sebaxe07/Tino-Robot/Tino-raspberrypi/README.md

# Tino-raspberrypi
si lavora qui in developmentsss
ready for new life
