sebaxe07/Tino-Robot/Thesis TinoV2/Chapters/implementation.tex

This chapter details the comprehensive implementation of the Tino V2 robot system, covering the complete redesign and upgrade of the platform. The implementation encompasses the transition from legacy Raspberry Pi-based architecture to a modern ROS2-based system running on NVIDIA Orin Nano, the integration of advanced sensing capabilities including SLAM and human detection, hardware redesign for improved reliability and performance, and the development of VR integration capabilities. Each section provides detailed technical implementation details, design decisions, and validation results that demonstrate the enhanced capabilities of the Tino V2 platform.
