sebaxe07/Tino-Robot/Thesis TinoV2/Images/bridgepos.png

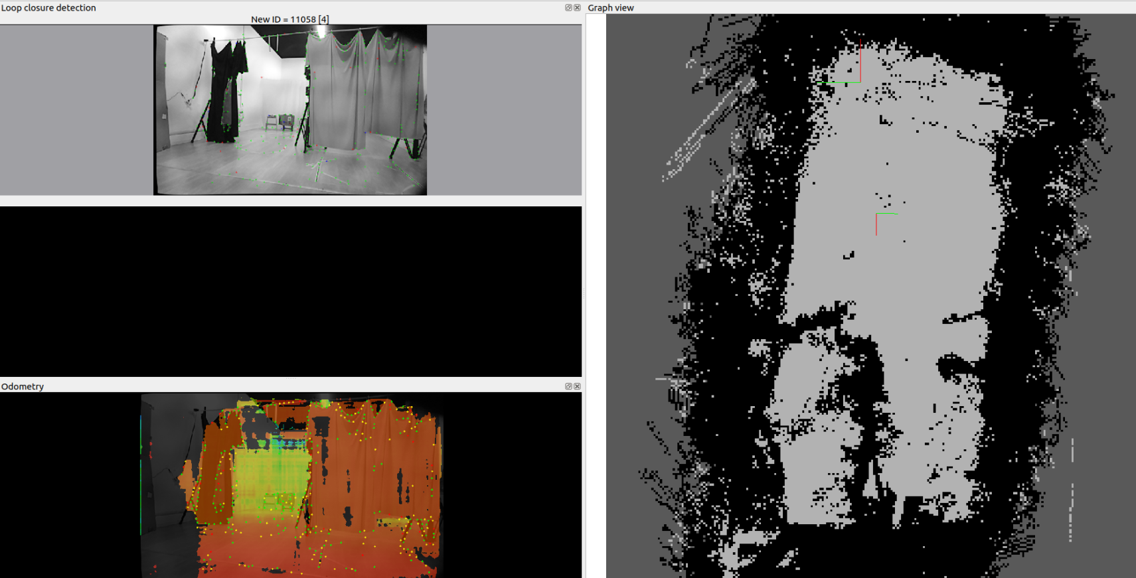
Thesis TinoV2/Images/bridgepos.png
