sebaxe07/Tino-Robot/Thesis TinoV2/Images/buttonpos.png

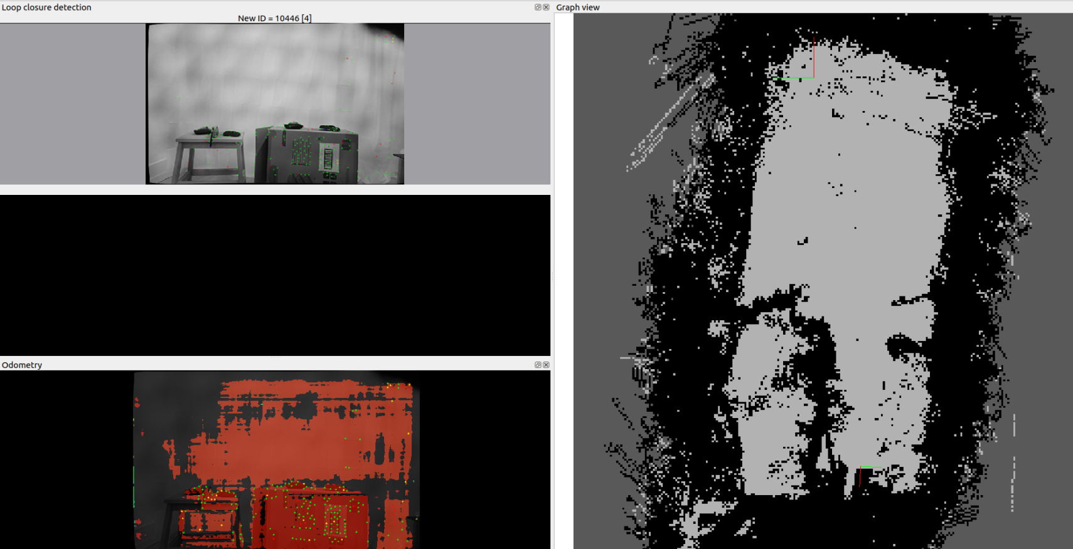
Thesis TinoV2/Images/buttonpos.png
