sebaxe07/Tino-Robot/Thesis TinoV2/Images/CameraCasingMesh (3).jpg

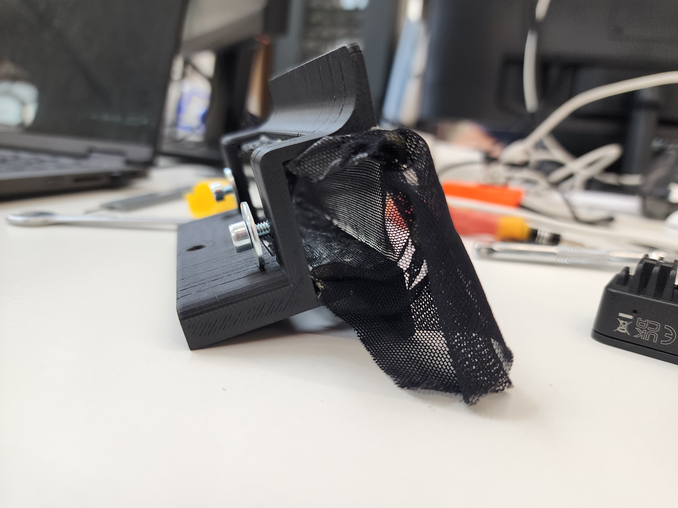
Thesis TinoV2/Images/CameraCasingMesh (3).jpg
