sebaxe07/Tino-Robot/Thesis TinoV2/Images/cleanRTABMap.png

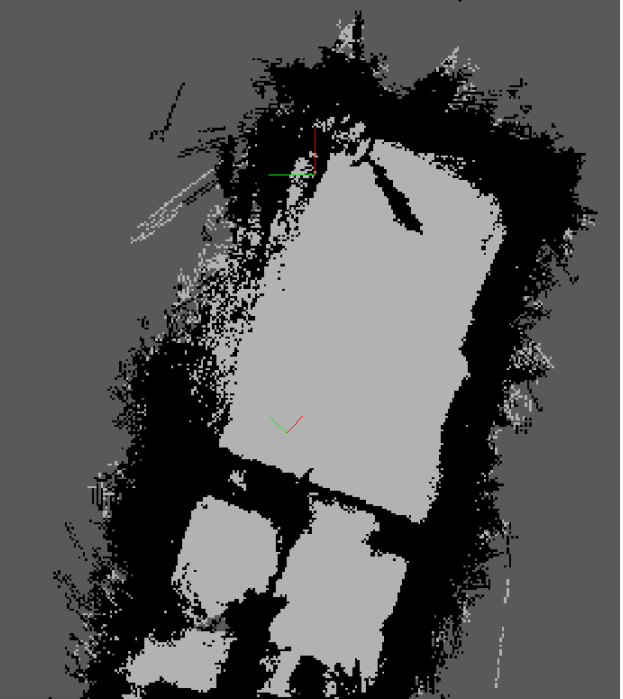
Thesis TinoV2/Images/cleanRTABMap.png
