sebaxe07/Tino-Robot/Thesis TinoV2/Images/InternalWithSpeakers.jpg

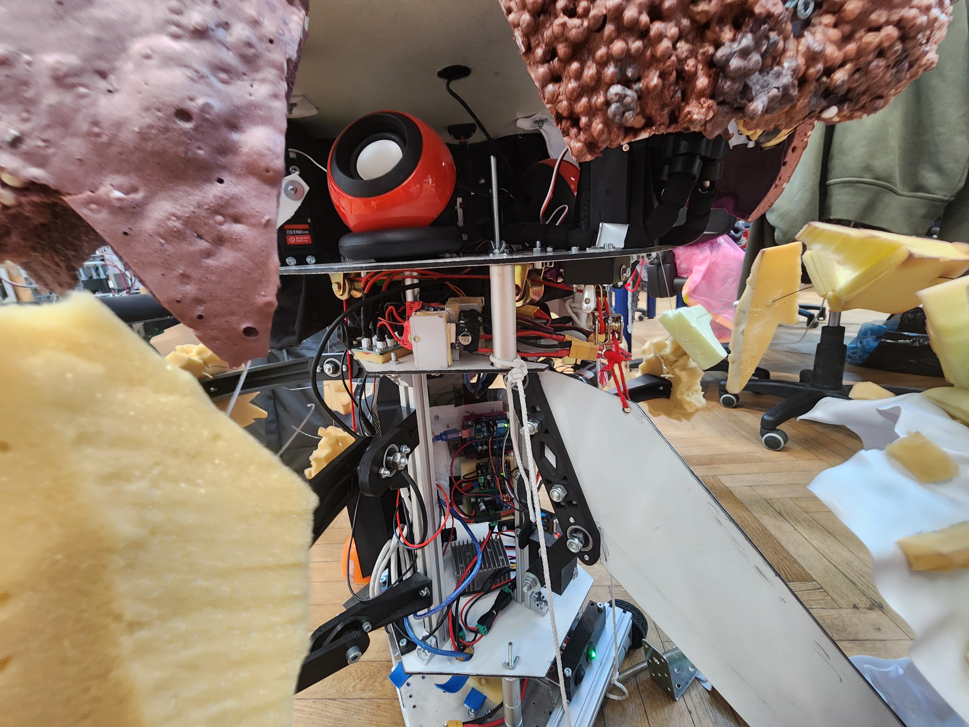
Thesis TinoV2/Images/InternalWithSpeakers.jpg
