sebaxe07/Tino-Robot/Thesis TinoV2/Images/NewBaseDifferentialDrive (4).jpg

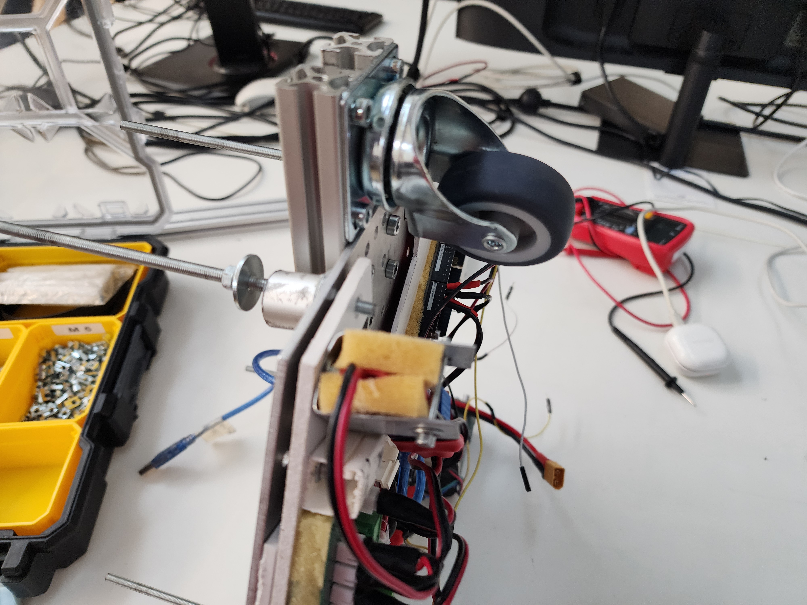
Thesis TinoV2/Images/NewBaseDifferentialDrive (4).jpg
