sebaxe07/Tino-Robot/Thesis TinoV2/Images/NewHeadDoubleJoint (3).jpg

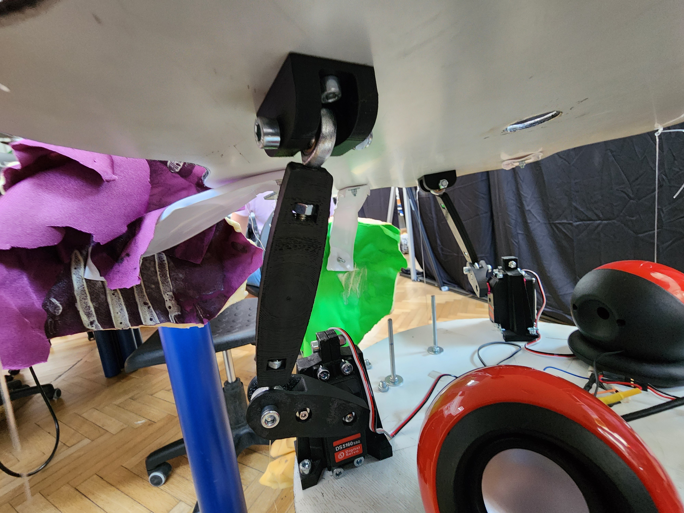
Thesis TinoV2/Images/NewHeadDoubleJoint (3).jpg
