sebaxe07/Tino-Robot/Thesis TinoV2/Images/NewHeadDoubleJoint.jpg

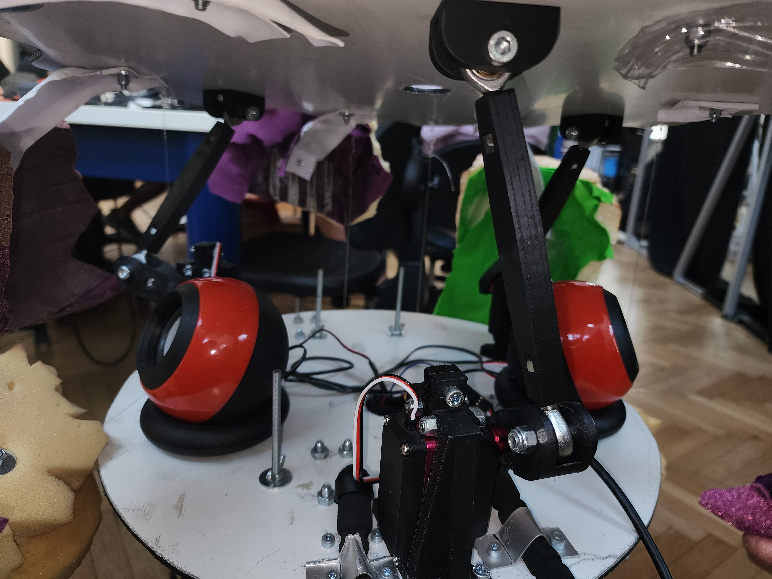
Thesis TinoV2/Images/NewHeadDoubleJoint.jpg
