sebaxe07/Tino-Robot/Thesis TinoV2/Images/OriginalTriskarBase.jpg

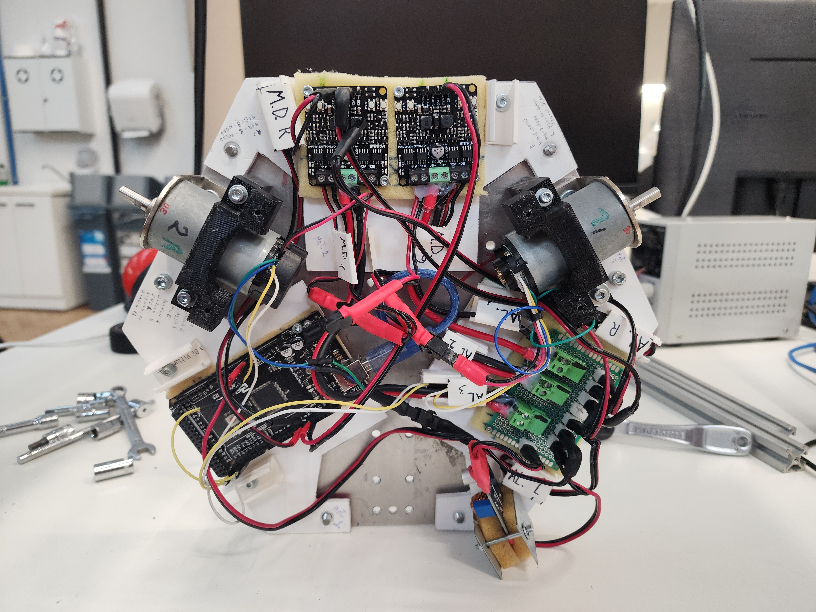
Thesis TinoV2/Images/OriginalTriskarBase.jpg
