sebaxe07/Tino-Robot/Thesis TinoV2/Images/platformpos.png

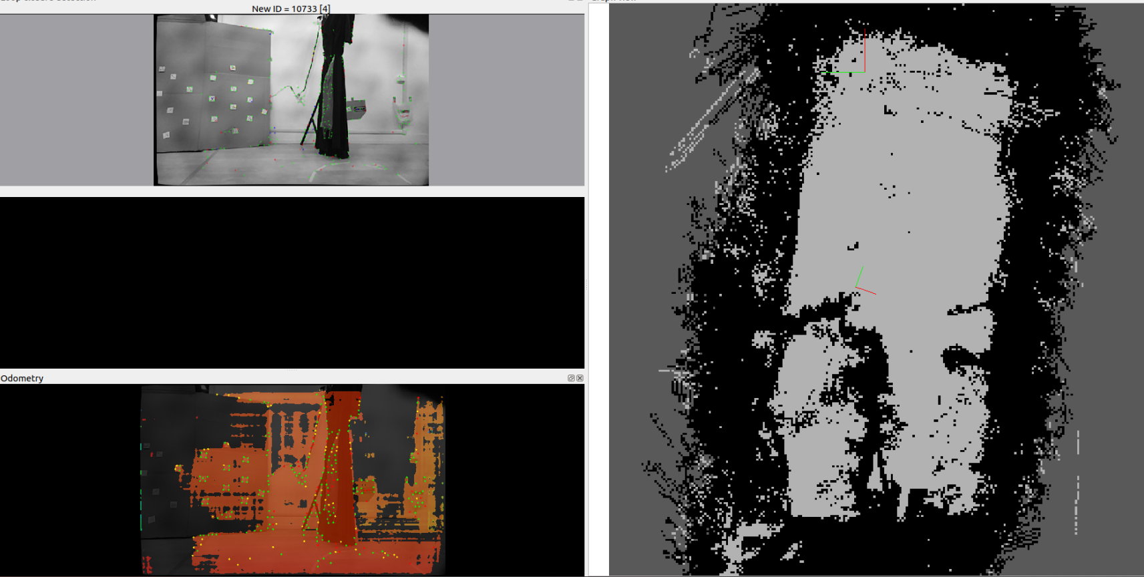
Thesis TinoV2/Images/platformpos.png
