sebaxe07/Tino-Robot/Thesis TinoV2/Images/TinoBumper (3).jpg

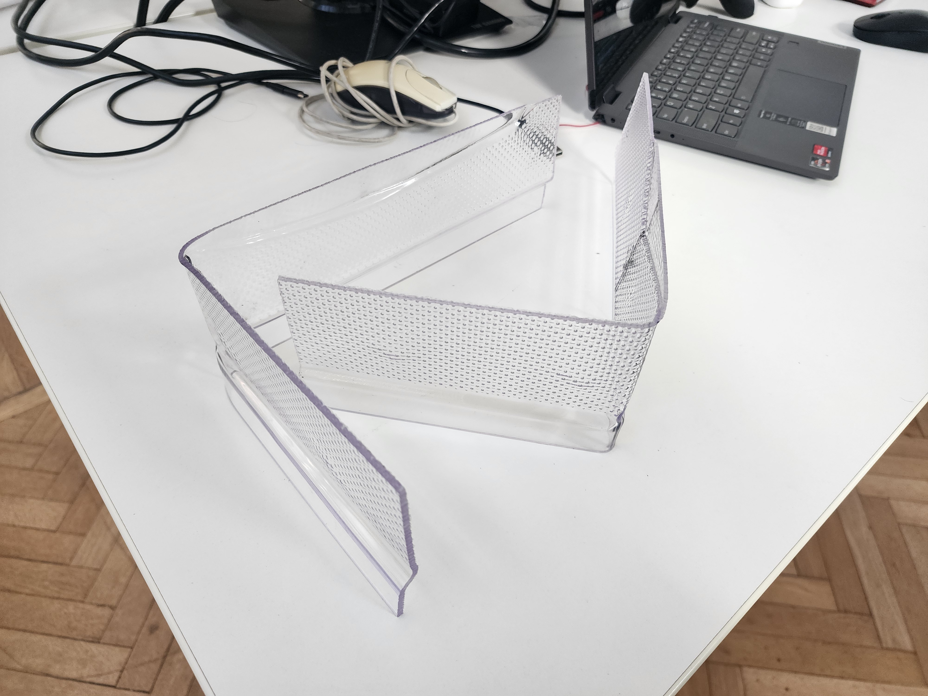
Thesis TinoV2/Images/TinoBumper (3).jpg
