sebaxe07/Tino-Robot/The Revenge of the Mazes(1-10).csv

ID | Start time | Completion time | Email | Name | Last modified time | Write the ID provided by Alessandro and Sebastian after the experiment | What is your gender? | How old are you? | What is your country of origin? | If you took part in both the experiences, which one did you do first? | Did you take part in the VR Experience? | What are three key words to describe your feelings during the experience? | I am familiar with VR | I felt uncomfortable using the VR headset today | I was able to navigate the environment | I felt like I was trapped | I felt I was able to go wherever I wanted | it was easy to move around | I felt like the obstacles were dangerous | the environment was interesting/stimulating | the environment was annoying | I felt immersed in the environment | I enjoyed the environment | it was easy/intuitive to understand how the game worked | it was easy/intuitive to understand how to interact with the objects | playing the game was frustrating | I felt as if the virtual body was my body | I felt as if the virtual body was an extension of my body | I felt like I could control the virtual body as if it was my own body | the movements of the virtual body were caused by my movements | I felt as if the movements of the virtual body were influencing my own movements | I felt out of my body | at some point I felt as if my real body was starting to take on the posture or shape of the virtual body | It was intuitive to move the virtual body | I enjoyed the movements of the virtual body | I enjoyed the appearance of the virtual body | I saw another being in the environment | I felt a connection with the other being | I was able to understand the other being | I wanted to communicate with the other being | I felt I was able to communicate with the other being | Have you seen this room? | What did you do there? | Did you interact with this platform? | If yes, what made you do it? | Did you find this room? | What did you do there?2 | Did you finish the game in this room? | Did you feel your emotions change during the experience? | How did your emotions change during the experience? | How much did you enjoy the VR experience? | What did you like the most about the experience? | What did you like the least about the experience? | Any final comments, suggestions, or rants? | Did you take part in the Robot experience? | I have seen/interacted with a robot before | I liked the robot appearance | Have you interacted with the Robot during the experience? | How much did the robot's appearance impact how you interacted with it?
3 | 7/21/25 6:56:20 | 7/21/25 7:12:52 | anonymous |  |  | 1 | Man | 24 | Italy | The Robot Experience | Yes | Amazed Stuck Frustrated | Strongly Agree | Strongly Disagree | More Disagree Than Agree | Strongly Agree | Disagree | Strongly Disagree | Strongly Agree | Agree | Disagree | Strongly Agree | Strongly Agree | Agree | More Disagree Than Agree | Disagree | More Disagree Than Agree | More Disagree Than Agree | More Disagree Than Agree | More Agree Than Disagree | More Agree Than Disagree | Agree | More Agree Than Disagree | Strongly Disagree | Disagree | Agree | Yes | More Agree Than Disagree | Disagree | Disagree | Strongly Disagree | Yes | Provato a schiacciare le piattaforme | Yes | Passarci sopra | Yes | Provato a entrarci | Yes | Yes | Prima ero divertito poi mi sono sentito frustrato perché Tino era davvero molto lento | 4 | The scene was very suggestive | Il movimento lento di Tino | Tino dovrebbe avere un buff sulla reattività ai miei controlli | Yes | Strongly Agree | Strongly Agree | Yes | 1
4 | 7/21/25 10:59:43 | 7/21/25 11:07:19 | anonymous |  |  | 3 | Man | 22 | Italy | I only took part in one experience | Yes | Puzzled, Amused, Frustrated | More Disagree Than Agree | Strongly Disagree | Agree | Agree | More Disagree Than Agree | More Agree Than Disagree | Disagree | Agree | Disagree | Strongly Agree | Agree | More Agree Than Disagree | Agree | Strongly Agree | More Disagree Than Agree | Agree | More Agree Than Disagree | Strongly Agree | Strongly Agree | Disagree | Disagree | Agree | More Disagree Than Agree | More Agree Than Disagree | Yes | Disagree | Disagree | Agree | Disagree | No |  | Yes | The bright color | No |  | No | No |  | 3 | The environment | Getting stuck
5 | 7/21/25 10:59:55 | 7/21/25 11:15:35 | anonymous |  |  | 2 | Man | 22 | Colombia | The VR Experience | Yes | Frustratrd, interested, Curious | Strongly Disagree | Strongly Disagree | Strongly Agree | More Disagree Than Agree | More Disagree Than Agree | Strongly Agree | More Agree Than Disagree | Strongly Agree | Disagree | Agree | Agree | Agree | Strongly Agree | Strongly Agree | Disagree | Disagree | Disagree | More Disagree Than Agree | Disagree | Disagree | More Disagree Than Agree | Disagree | Disagree | Disagree | Yes | More Agree Than Disagree | More Agree Than Disagree | Disagree | More Disagree Than Agree | Yes | I went to step into the button | Yes | It was glowing | No |  | No | No |  | 3 | The scape room part | The movement of the VR body |  | Yes | Disagree | Agree | Yes | 5
6 | 7/21/25 11:32:39 | 7/21/25 11:42:57 | anonymous |  |  | 4 | Woman | 53 | Italy | I only took part in one experience | No |  |  |  |  |  |  |  |  |  |  |  |  |  |  |  |  |  |  |  |  |  |  |  |  |  |  |  |  |  |  |  |  |  |  |  |  |  |  |  |  |  |  |  | Yes | Strongly Disagree | More Agree Than Disagree | Yes | 6
7 | 7/21/25 12:09:28 | 7/21/25 12:34:03 | anonymous |  |  | 5 | Woman | 21 | Italy | The VR Experience | Yes | Confusione, frustrazione, simpatico | Agree | More Agree Than Disagree | More Agree Than Disagree | More Agree Than Disagree | Disagree | Disagree | Disagree | More Agree Than Disagree | More Disagree Than Agree | Agree | More Disagree Than Agree | More Agree Than Disagree | Strongly Agree | More Disagree Than Agree | Disagree | More Agree Than Disagree | Strongly Disagree | Agree | Strongly Agree | Disagree | Disagree | More Disagree Than Agree | Disagree | More Agree Than Disagree | Yes | Disagree | More Agree Than Disagree | Strongly Agree | More Agree Than Disagree | Yes | sono andata al cerchio blu in fondo | Yes | istinto | Yes | Su uno dei pulsanti | Yes | Yes | Stanchezza ma felicità di essere arrivata alla fine | 3 | Usare il Vr | Confusione |  | Yes | Strongly Agree | More Agree Than Disagree | Yes | 6
8 | 7/21/25 12:38:47 | 7/21/25 12:43:46 | anonymous |  |  | 7 | Man | 23 | Colombia | The VR Experience | Yes | Interesting, nauseous, lost | Agree | More Agree Than Disagree | Agree | More Disagree Than Agree | More Agree Than Disagree | More Agree Than Disagree | More Disagree Than Agree | Disagree | More Disagree Than Agree | Disagree | More Agree Than Disagree | Agree | Agree | More Agree Than Disagree | Disagree | More Disagree Than Agree | More Disagree Than Agree | More Agree Than Disagree | More Agree Than Disagree | More Disagree Than Agree | Agree | More Agree Than Disagree | More Disagree Than Agree | Disagree | Yes | Disagree | More Disagree Than Agree | Disagree | More Disagree Than Agree | Yes | Press the shiny button | Yes | Shiny | Yes | Point to a button | Yes | Yes | It was funny anyway | 3 | Using a vr | I was getting nauseous in the end |  | No
9 | 7/21/25 12:39:04 | 7/21/25 14:04:18 | anonymous |  |  | 6 | Man | 29 | Italy | The VR Experience | Yes | Immersive, confusing, interesting | Strongly Agree | Strongly Disagree | More Disagree Than Agree | Disagree | Disagree | More Disagree Than Agree | More Agree Than Disagree | More Disagree Than Agree | More Disagree Than Agree | More Agree Than Disagree | More Agree Than Disagree | More Agree Than Disagree | Agree | Agree | Disagree | More Agree Than Disagree | Strongly Disagree | More Agree Than Disagree | Agree | More Disagree Than Agree | Disagree | Disagree | More Disagree Than Agree | More Disagree Than Agree | Yes | More Disagree Than Agree | More Disagree Than Agree | More Agree Than Disagree | Disagree | Yes | I tried to move towards the blue circle opposite to me, because I thought it would activate some mechanism | Yes | I thought it would activate some kind of mechanism | Yes | I tried to move forward but I was stuck so I didn't finish the experiment | No | Yes | Much struggling | 3 | The fact that I was moving the robot using the VR and the bar | The movement, I didn't understand them | I understand that the objective of the experiment is to impersonificate the non-antropomorphic body, but I think some kind of disclaimer before starting could be nice | Yes | Agree | More Agree Than Disagree | Yes | 7
10 | 7/22/25 10:00:39 | 7/22/25 10:43:10 | anonymous |  |  | 9 | Man | 25 | Italy | The Robot Experience | Yes | Mysterious, hard, handicapped | More Agree Than Disagree | More Disagree Than Agree | Agree | Agree | More Disagree Than Agree | More Disagree Than Agree | Agree | Agree | More Disagree Than Agree | Agree | Agree | More Agree Than Disagree | More Agree Than Disagree | More Agree Than Disagree | Disagree | More Disagree Than Agree | Disagree | More Agree Than Disagree | Agree | Agree | More Disagree Than Agree | More Disagree Than Agree | More Disagree Than Agree | More Disagree Than Agree | Yes | More Agree Than Disagree | More Agree Than Disagree | Agree | More Agree Than Disagree | Yes | I tried to reach the second blue disk | No |  | No |  | No | Yes | Doubt, fear, fatigue | 4 | The fear induced by entering in the mud zone | The controls |  | Yes | Disagree | More Disagree Than Agree | Yes | 7
11 | 7/22/25 10:00:38 | 7/22/25 10:44:05 | anonymous |  |  | 8 | Man | 24 | Italy | The VR Experience | Yes | Unresponsive, Intriguing, Colorful | Disagree | Strongly Disagree | Strongly Disagree | Strongly Agree | Strongly Disagree | Strongly Disagree | Disagree | More Agree Than Disagree | Disagree | Strongly Agree | More Agree Than Disagree | Strongly Disagree | Strongly Disagree | Agree | Strongly Disagree | Strongly Disagree | Strongly Disagree | More Disagree Than Agree | Disagree | Agree | Agree | Strongly Disagree | Strongly Disagree | More Disagree Than Agree | No |  |  |  |  | Yes | Moved to a button | Yes | it made me stuck | No |  | No | No |  | 2 | the environment | the movement inputs | I felt the game was unresponsive | Yes | Agree | Strongly Agree | No
12 | 7/24/25 9:23:02 | 7/24/25 10:28:30 | anonymous |  |  | 10 | Man | 25 | Italia | The VR Experience | Yes | Complicità, Sorpreso, Limitato | Agree | Strongly Disagree | Agree | More Agree Than Disagree | More Agree Than Disagree | More Disagree Than Agree | More Disagree Than Agree | Strongly Agree | Disagree | Agree | Agree | Agree | Agree | More Agree Than Disagree | More Disagree Than Agree | More Disagree Than Agree | More Disagree Than Agree | Agree | More Disagree Than Agree | More Disagree Than Agree | More Disagree Than Agree | Agree | More Agree Than Disagree | More Agree Than Disagree | Yes | Agree | Agree | Agree | More Agree Than Disagree | Yes | Sono andato su una piattaforma | Yes | Ho pensato che dovessi andare su una il e su una l’altro essere vivente | Yes | Quasi nulla | No | Yes | Rimasto sorpreso, salita un po’ di frustrazione nel non riuscire a muovermi esattamente come mi aspettassi | 5 | L’ambientazione | Il fatto che non mi muovessi tanto quanto sembrava allungare il braccio | Farei in modo che il movimento arrivi a dove ho allungato il braccio | Yes | More Disagree Than Agree | More Agree Than Disagree | Yes | 3
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
