sebaxe07/Tino-Robot/Thesis TinoV2/Images/ExpSetup.png

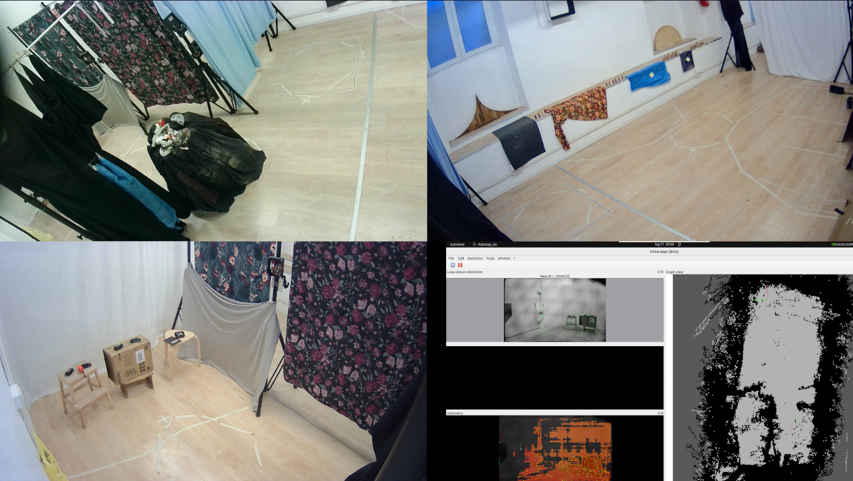
Thesis TinoV2/Images/ExpSetup.png
