sebaxe07/Tino-Robot/Thesis TinoV2/Images/LabExperimentBefore.jpg

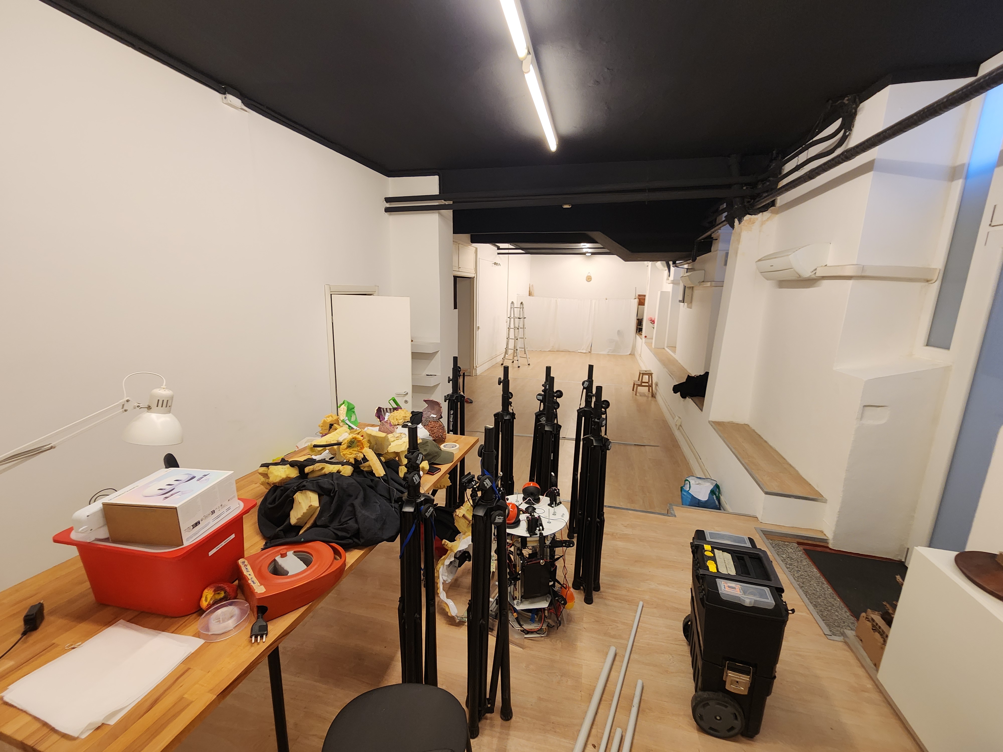
Thesis TinoV2/Images/LabExperimentBefore.jpg
