sebaxe07/Tino-Robot/Thesis TinoV2/Images/WheelCenterFailure (2).jpg

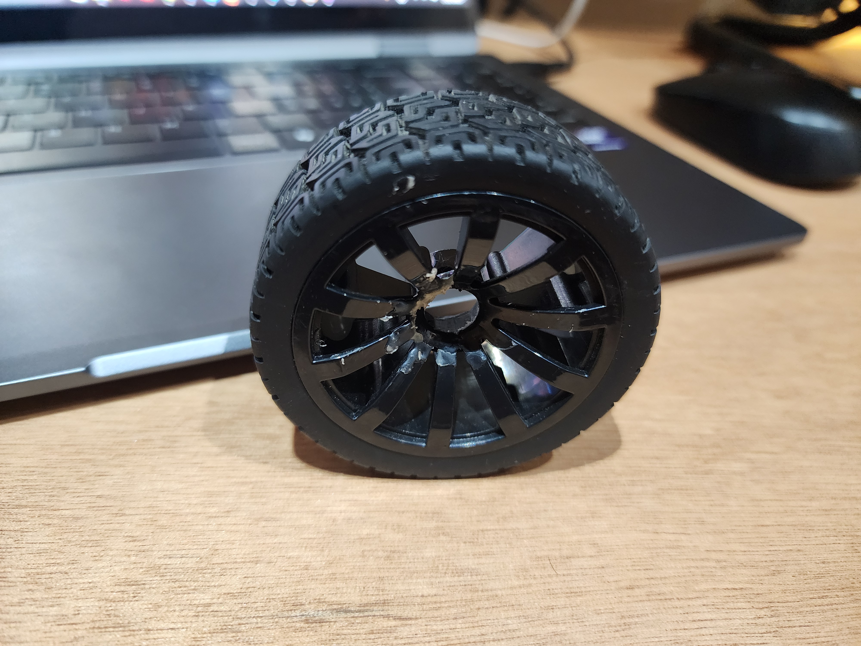
Thesis TinoV2/Images/WheelCenterFailure (2).jpg
