sebaxe07/Tino-Robot/Thesis TinoV2/Images/WheelCenterFailure.jpg

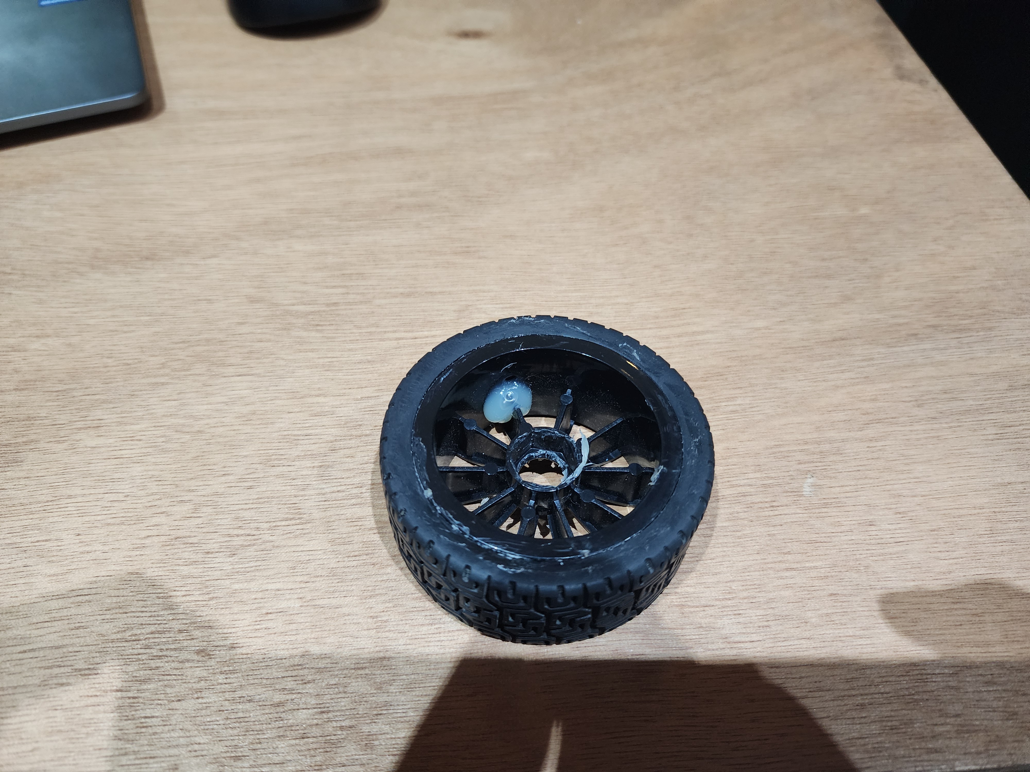
Thesis TinoV2/Images/WheelCenterFailure.jpg
