sebaxe07/Tino-Robot/Thesis TinoV2/Images/02_ING_IND_INFORMAZIONE_COL_POSITIVO-eps-converted-to.pdf

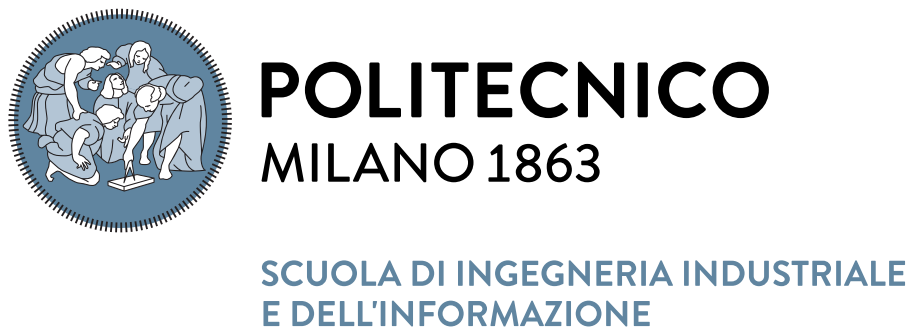
[picture p62: page 1]
