sebaxe07/Tino-Robot/Thesis TinoV2/Images/raggiera_polimi-eps-converted-to.pdf

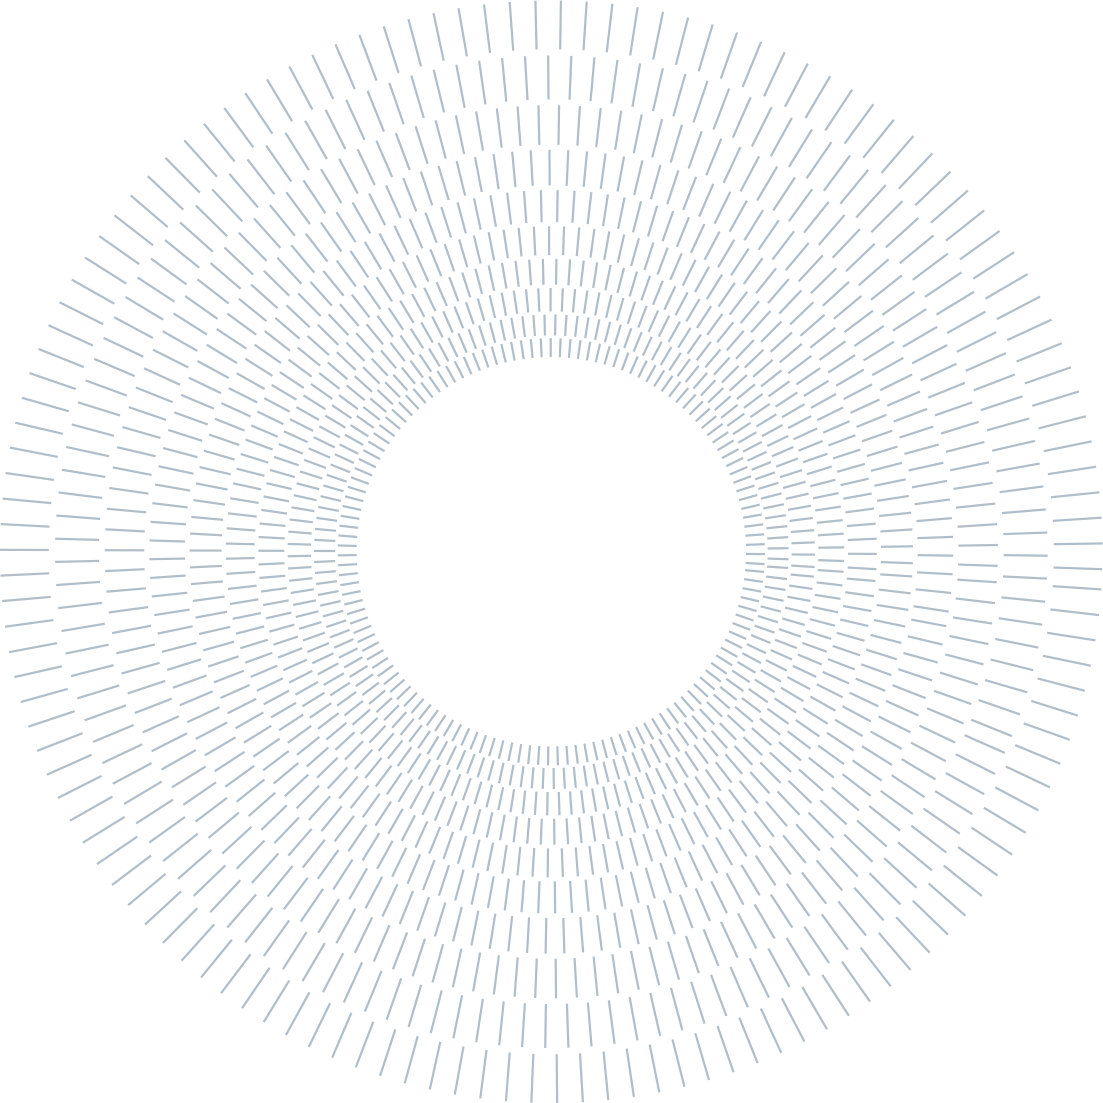
[picture p63: page 1]
