sebaxe07/Tino-Robot/base_tino/pinout.h

// MOTORS 
// encoder pins
#define _EP11 2 // white back motor
#define _EP12 3// yellow back motor
#define _EP21 19// white right motor
#define _EP22 18// yellow right motor
#define _EP31 21// white left motor
#define _EP32 20// yellow left motor

// driver pins
#define _1_1A 8 // red right motor
#define _1_1B 9  // black right motor
#define _1_2A 10  // red left motor
#define _1_2B 11  // black left motor
#define _2_1A 6  // red back motor
#define _2_1B 7  // black back motor
