sebaxe07/Tino-Robot/tino_ws/src/uwb_positioning/scripts/dwm1001_systemDefinitions.py

# """
# ===================================================================
# |                                                                 |
# |  COPYRIGHT NOTICE                                               |
# |                                                                 |
# |  This code is developed by OpenIoT - Open Platforms and         |
# |  Enabling Technologies for the Internet of Things.              |
# |                                                                 |
# |  Developer: Farhad Shamsfakhr, PhD                              |
# |  Affiliation: Fondazione Bruno Kessler (FBK)                    |
# |  Address: via Sommarive, 18 38123 Povo, Trento (Italy)          |
# |                                                                 |
# |  This project is sponsored by the Agri-Food project,            |
# |  coordinated by FONDAZIONE BRUNO KESSLER.                       |
# |  Funded under the Digital Europe Programme (DIGITAL).           |                        |
# |                                                                 |
# |  © [2024] Farhad Shamsfakhr, PhD. All rights reserved.          |
# |                                                                 |
# ===================================================================
# """
#!/usr/bin/env python3

__author__     = "Farhad Shamsfakhr"
__version__    = "1.0"
__maintainer__ = "Farhad Shamsfakhr"
__email__      = "fshamsfakhr@gmail.com"
__status__     = "Development"
import serial

class SYS_DEFS:

    AUTHOR          = "Farhad Shamsfakhr"
    VERSION         = "1.0"
    MAINTAINER      = "Farhad Shamsfakhr"
    EMAIL           = "fshamsfakhr@gmail.com"
    STATUS          = "Development"



    baudRate = 115200
    parity = serial.PARITY_ODD
    stopbits = serial.STOPBITS_TWO
    bytesize = serial.SEVENBITS

    INDEX_0     = 0
    INDEX_1     = 1
    INDEX_2     = 2
    INDEX_3     = 3
    INDEX_4     = 4
    INDEX_5     = 5
    INDEX_6     = 6
    INDEX_7     = 7
    INDEX_8     = 8
    INDEX_9     = 9
    INDEX_10    = 10
    INDEX_11    = 11
    INDEX_12    = 12
    INDEX_13    = 13
    INDEX_14    = 14
    INDEX_15    = 15
    INDEX_16    = 16
    INDEX_17    = 17
    INDEX_18    = 18
    INDEX_19    = 19
    INDEX_20    = 20
    INDEX_21    = 21
    INDEX_22    = 22
    INDEX_23    = 23
    INDEX_24    = 24
    INDEX_25    = 25
    INDEX_26    = 26
    INDEX_27    = 27
    INDEX_28    = 28
    INDEX_29    = 29
    INDEX_30    = 30
    INDEX_31    = 31
    INDEX_32    = 32
    INDEX_33    = 33
    INDEX_34    = 34
    INDEX_35    = 35
    INDEX_36    = 36
    INDEX_37    = 37
    INDEX_38    = 38
    INDEX_39    = 39
    INDEX_40    = 40
