sebaxe07/Tino-Robot/(commit log)

2025-04-28 Update README.md to reflect the transition from Raspberry Pi to ROS2-based implementation, detailing current and legacy system architectures, hardware and software components, and setup instructions.
2025-05-08 Refactor serial communication and motor control for new base implementation; update port configurations, add debugging logs, and enhance command handling.
2025-05-08 Add scripts for Arduino symlink setup and head sketch upload
2025-05-09 Refactor hardware interface and gamepad node for improved command handling and error reporting; update serial port configurations and enhance movement command processing.
    [RaspberryCommunication.cpp, RaspberryCommunication.h, gamepad_node.py, hardware_interface_node.py, new_head_tino.ino]
2025-05-26 Enable debug mode and add debug print functions for improved logging; update launch files to include new parameters and nodes for better integration.
2025-05-28 Add audio configuration setup for USB devices in robot controller node and create setup script
2025-05-28 Enhance audio setup in robot controller node; add checks for USB audio device and PulseAudio status on startup, and integrate audio setup script execution if needed.
2025-05-28 Enhance audio setup checks in robot controller node; add timeouts for USB audio device and PulseAudio status checks, and run setup script in background to prevent blocking.
    [robot_controller_node.py]
2025-06-05 Enhance VR interface odometry check; simplify condition for detecting odometry loss.
2025-06-25 Enhance Raspberry communication; add special command processing and periodic status updates in the main loop.
2025-07-11 Update motor speed and angular parameters for improved performance
2025-07-15 Full system for the leg and base redesigned to work with the VR system
    [RaspberryCommunication.cpp, RaspberryCommunication.h, gamepad_node.py, new_base_tino.ino, new_head_tino.ino, new_leg_tino.ino]
2025-07-15 Remove logging statements from leg and rotation command triggers for cleaner output
2025-07-15 Enhance position control by adding PID for holding position and modifying movement logic for case 3 extension
2025-07-16 Improved Reset odometry logic, added map offset to align with unity cartesian plane
    [hardware_interface_node.py, new_leg_tino.ino, robot_controller_node.py, vr_interface_node.py]
2025-07-18 General changes and fixes for experiment, UDP finishing touches, Depht Aligment
    [new_base_tino.ino, new_leg_tino.ino, pose_detection_node.py, robot_controller_node.py]
2025-07-18 Fixed UWB files to compile with ROS
    [main.py]
2025-07-18 Enhance UWB integration: Update scripts and nodes for device symlink setup and UWB positioning
2025-09-17 Final Thesis touches before review
    [The Revenge of the Mazes(1-10).csv]
