sebaxe07/Tino-Robot/Thesis TinoV2/Images/TripodOnHeadCamera.jpg

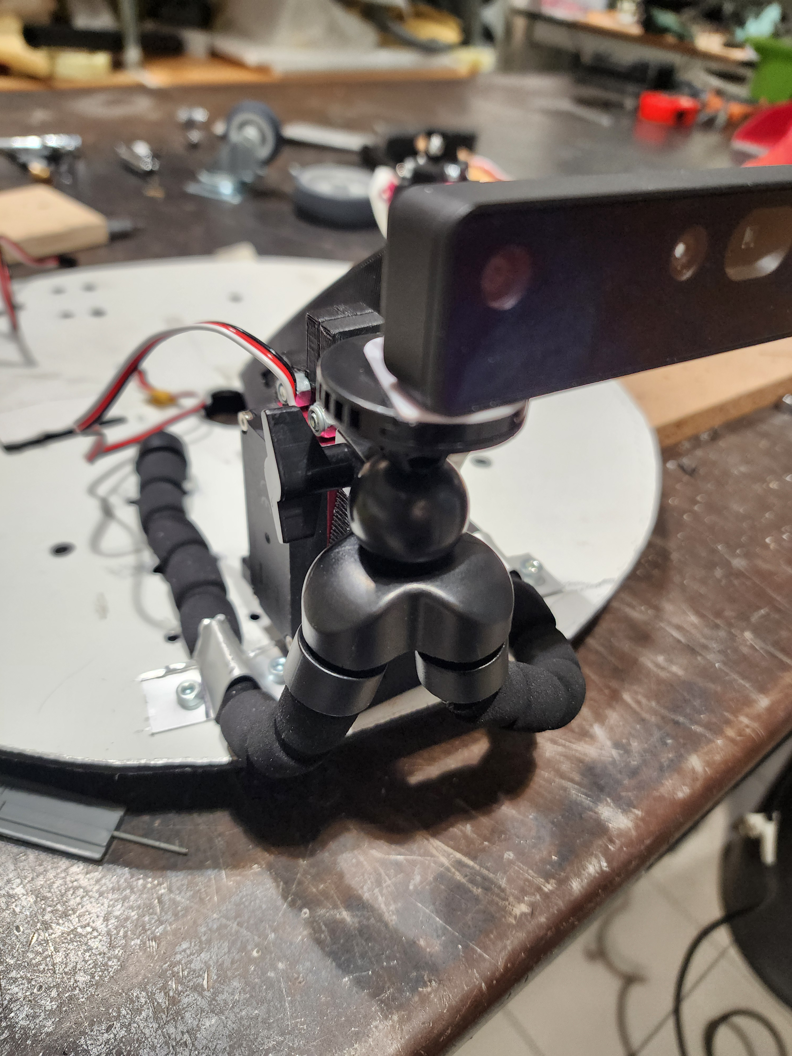
[picture p26: Thesis TinoV2/Images/TripodOnHeadCamera.jpg]
Thesis TinoV2/Images/TripodOnHeadCamera.jpg
