sebaxe07/Tino-Robot/Thesis TinoV2/Images/TripodOnHeadCamera (3).jpg

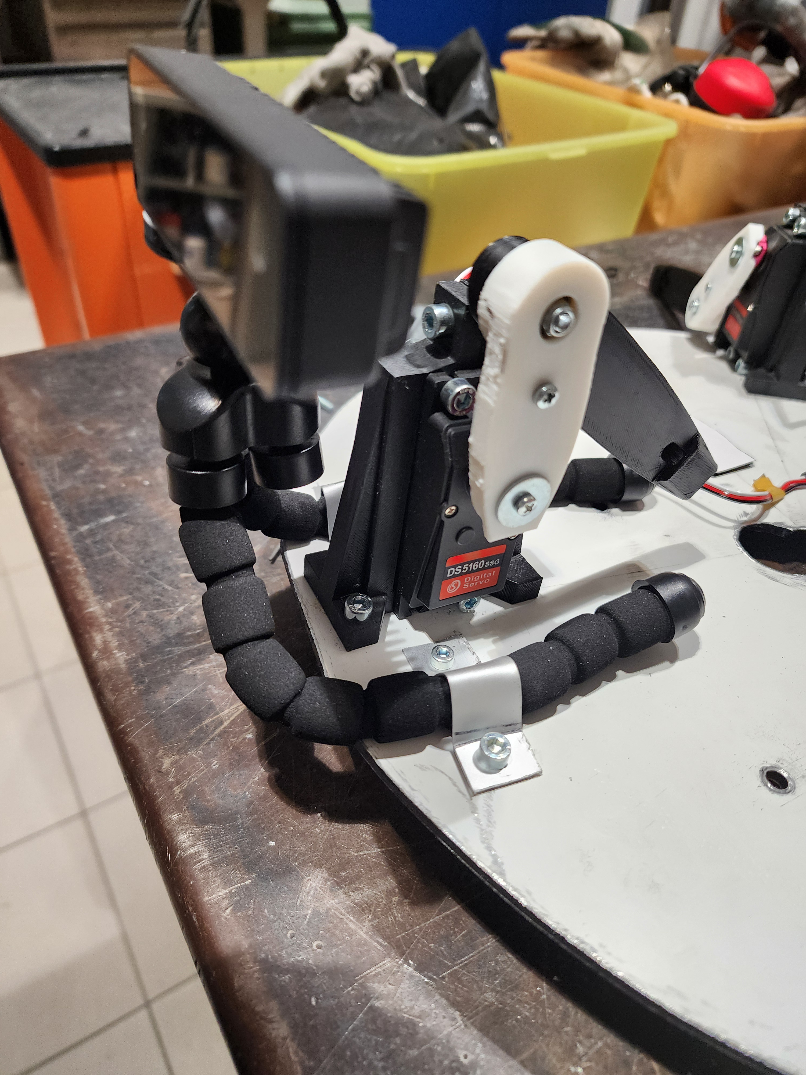
[picture p27: Thesis TinoV2/Images/TripodOnHeadCamera (3).jpg]
Thesis TinoV2/Images/TripodOnHeadCamera (3).jpg
