sebaxe07/Tino-Robot/Thesis TinoV2/Images/TripodOnHeadCamera (2).jpg

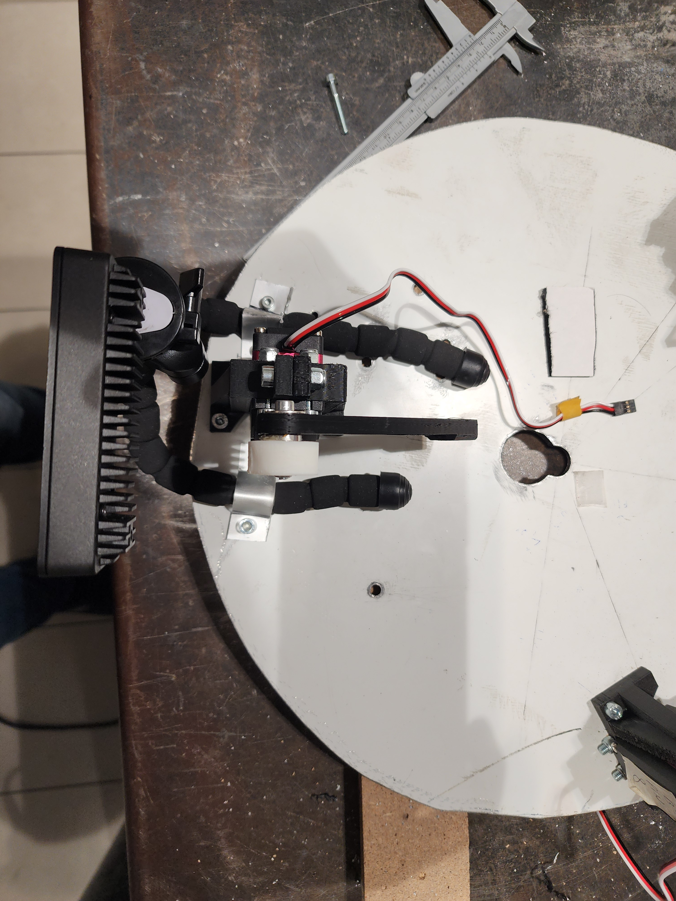
[picture p28: Thesis TinoV2/Images/TripodOnHeadCamera (2).jpg]
Thesis TinoV2/Images/TripodOnHeadCamera (2).jpg
