sebaxe07/Tino-Robot/Thesis TinoV2/Images/CameraCasingNoMesh.jpg

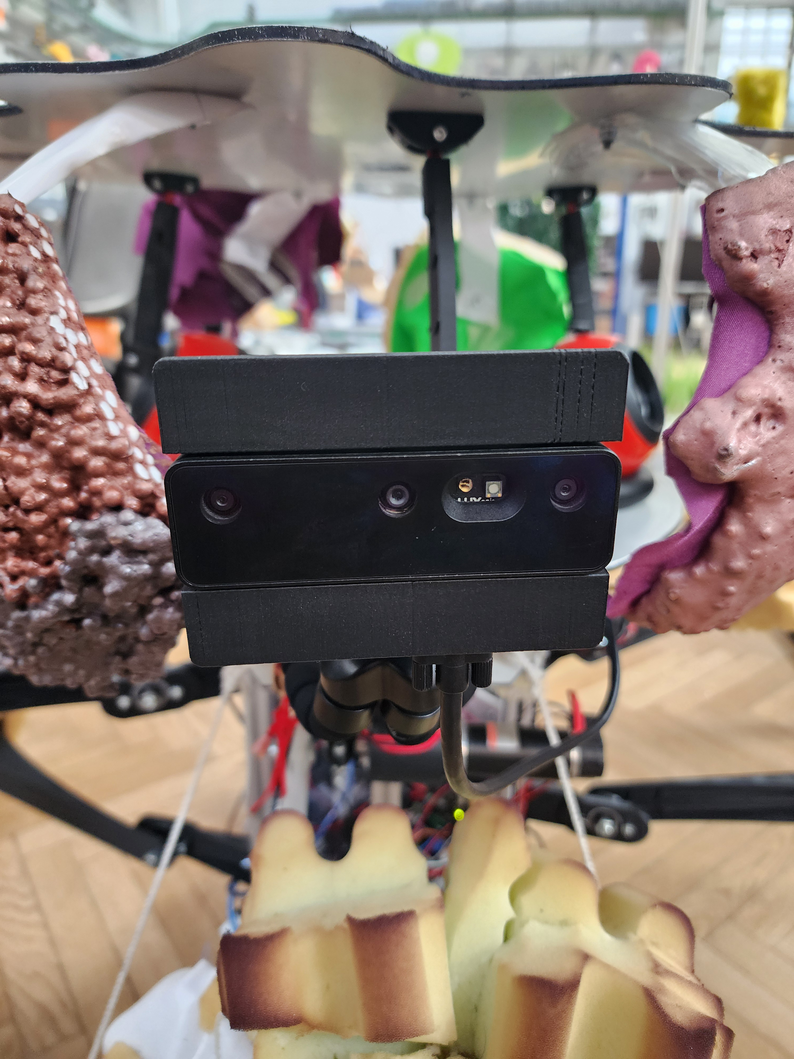
[picture p31: Thesis TinoV2/Images/CameraCasingNoMesh.jpg]
Thesis TinoV2/Images/CameraCasingNoMesh.jpg
