sebaxe07/Tino-Robot/Thesis TinoV2/Images/CameraCasingNoMesh (2).jpg

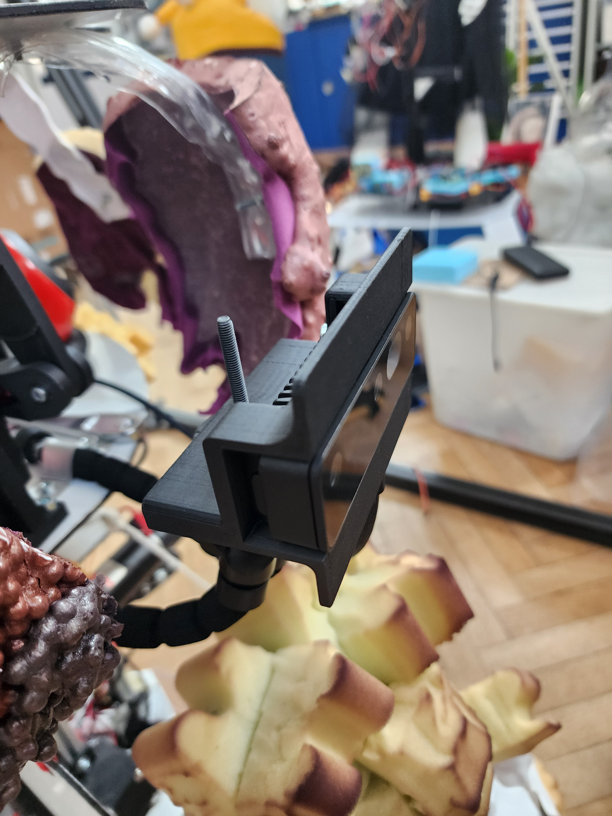
Thesis TinoV2/Images/CameraCasingNoMesh (2).jpg
