sebaxe07/Tino-Robot/Thesis TinoV2/Images/WheelVSFabric.jpg

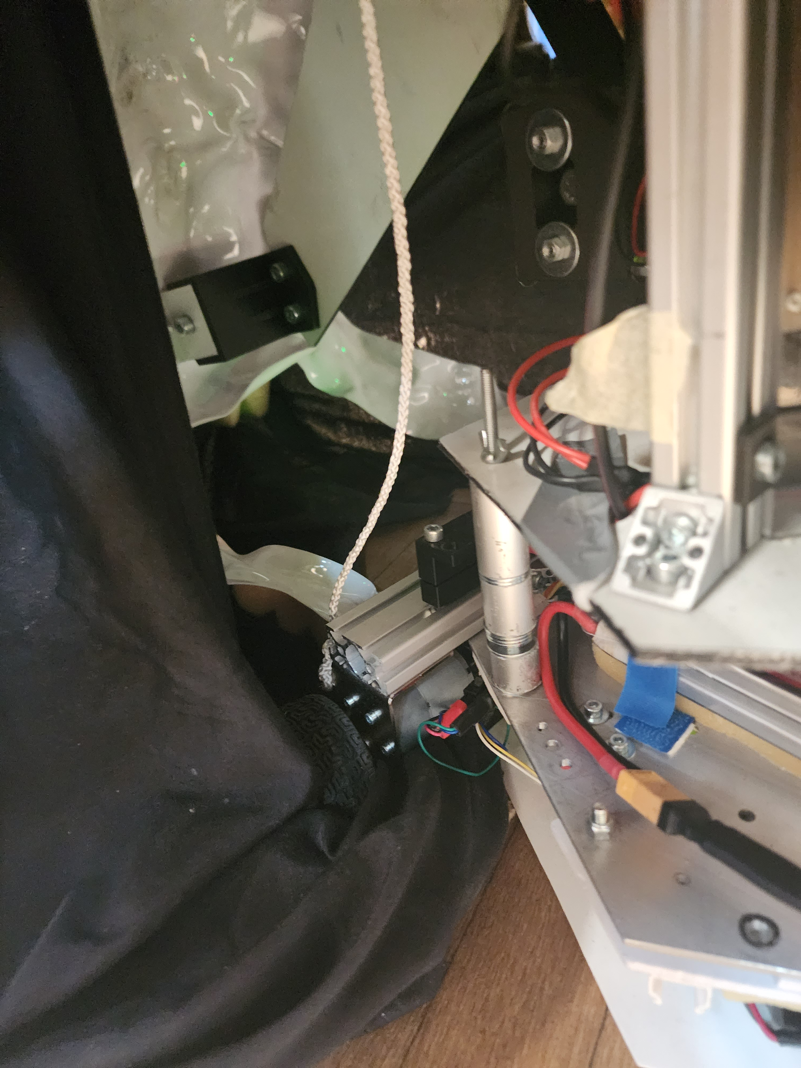
Thesis TinoV2/Images/WheelVSFabric.jpg
